zhaoyingpu/hpe-gen10-fan-proxy/(threads)

Thread 1 (2025-01-05):

Thank You 🍻

soulteary, 2025-01-05:
Thank you very much, this project has been of great help and saved a lot of time. I plan to continue based on this and do some exploration into other devices.

- https://github.com/soulteary/hpe-gen10-fan-proxy

hope everything goes well

zhaoyingpu, 2025-01-06:
I am glad this project was helpful.

wu0lei, 2025-08-21:
请问楼主买的什么规格的BMC散热片
