zhaoyingpu/hpe-gen10-fan-proxy/(commit log)

2024-04-22 fixed connector pin
2024-04-22 add arduino about
